KVR-CIBER/luchtmeter-s3/fab/render_bottom.png

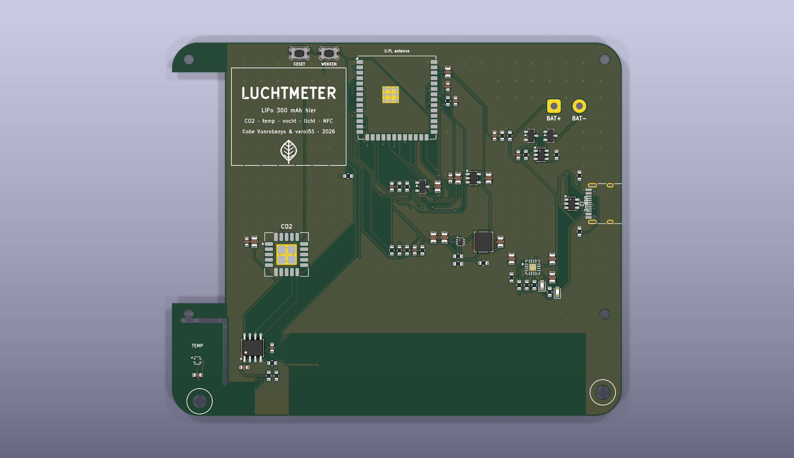
fab/render_bottom.png
