KVR-CIBER/luchtmeter-s3/fab/render_top.png

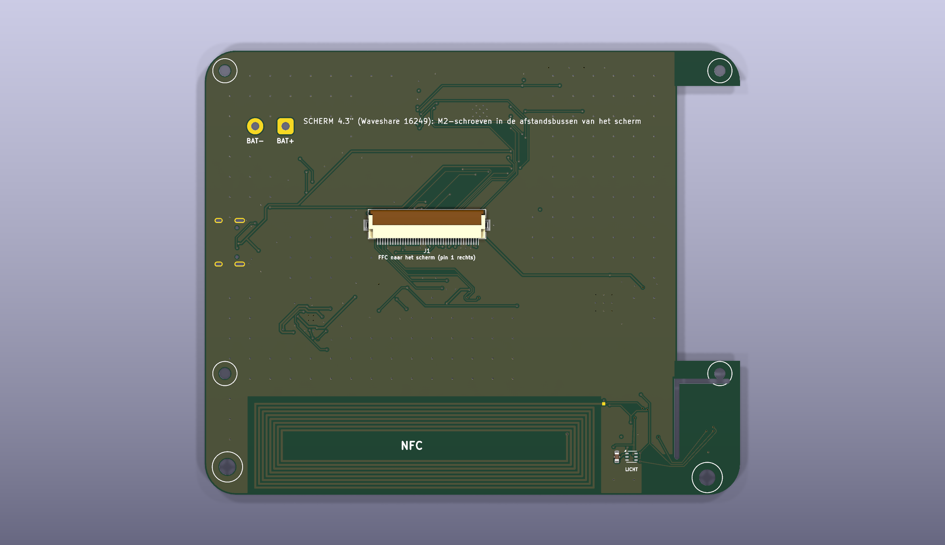
fab/render_top.png
