KVR-CIBER/luchtmeter-s3/fab/render_3d.png

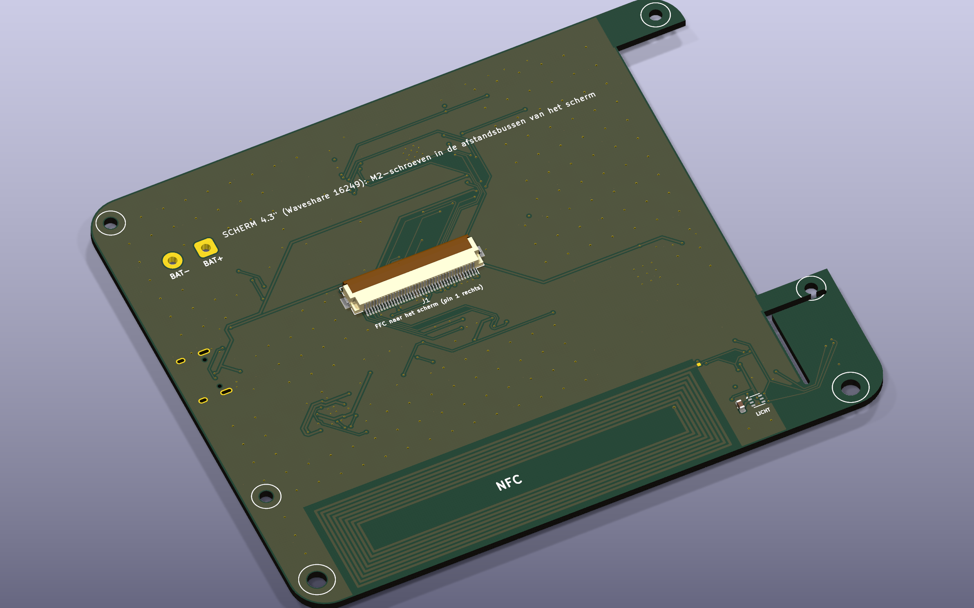
fab/render_3d.png
