KVR-CIBER/luchtmeter-s3/video/stills/luchtmeter_3s.jpg

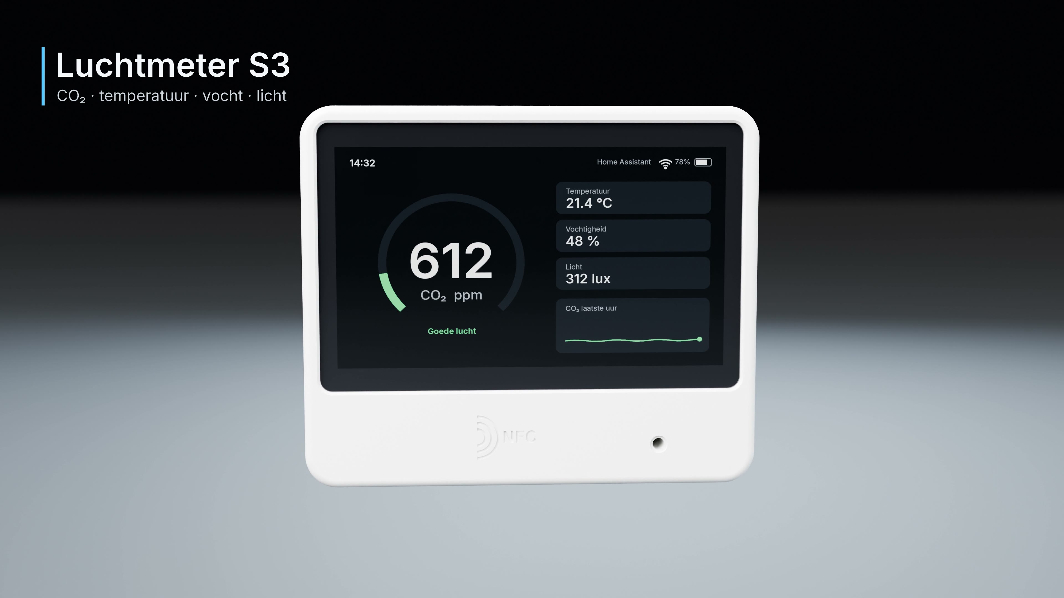
video/stills/luchtmeter_3s.jpg
