KVR-CIBER/luchtmeter-s3/video/stills/luchtmeter_13s.jpg

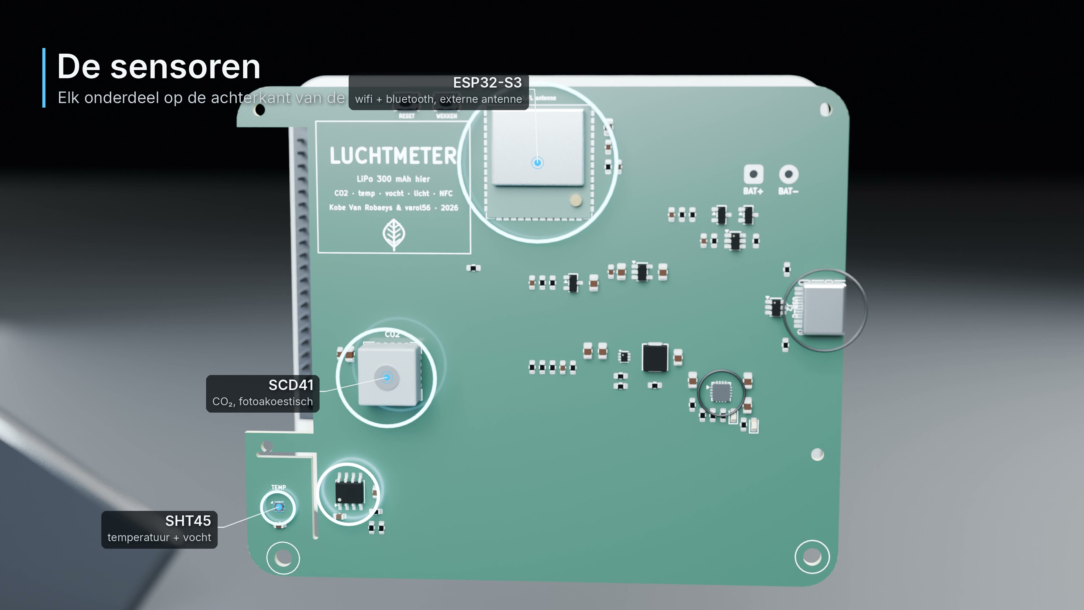
video/stills/luchtmeter_13s.jpg
