KVR-CIBER/luchtmeter-s3/video/stills/luchtmeter_23s.jpg

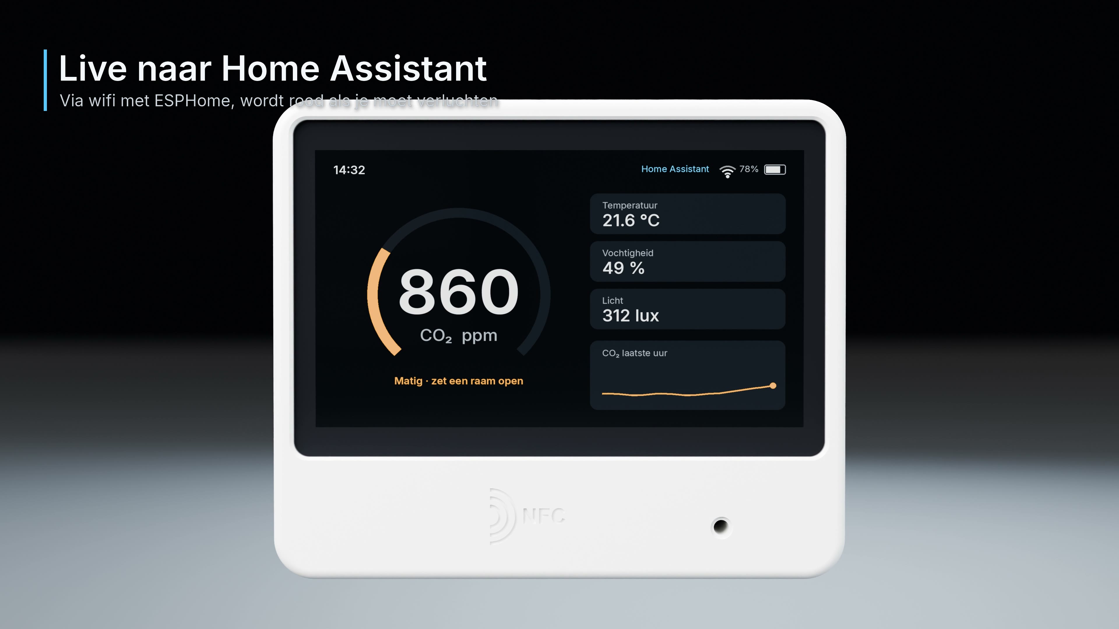
video/stills/luchtmeter_23s.jpg
