KVR-CIBER/luchtmeter-s3/video/stills/luchtmeter_31s.jpg

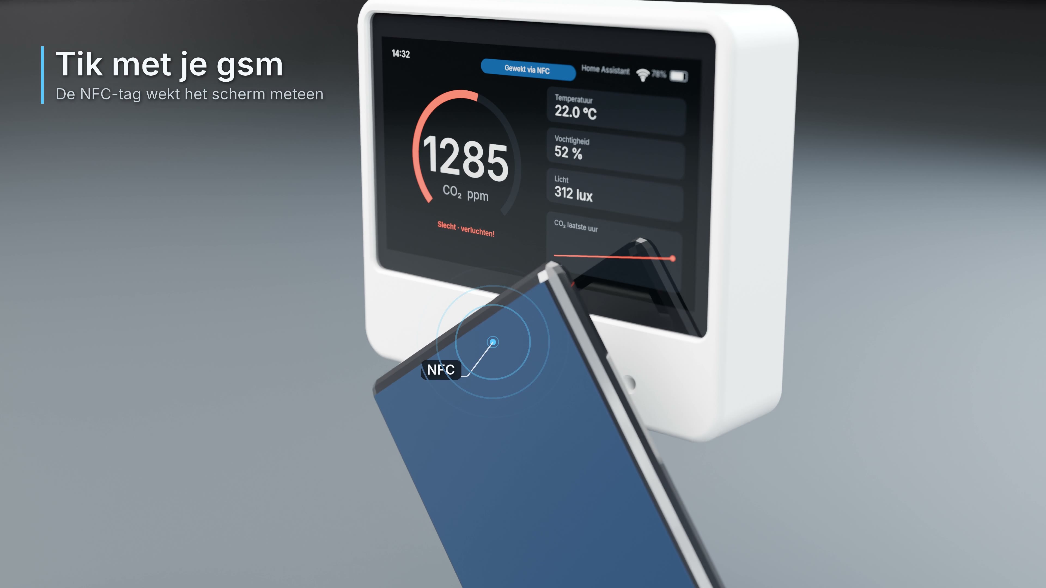
video/stills/luchtmeter_31s.jpg
