KVR-CIBER/luchtmeter-s3/fab/luchtmeter_BOM_JLCPCB.csv

Comment | Designator | Footprint | Quantity | MPN / note | LCSC Part #
ESP32-S3-WROOM-1U-N16R8 | U1 | ESP32-S3-WROOM-1U | 1 | ESP32-S3-WROOM-1U-N16R8 (U.FL; use a 2.4 GHz flex/dipole antenna at the top of the case) | C3013946
22u | C1,C10,C15,C16 | C_0805_2012Metric | 4 | 0805 22u X5R ceramic | C29277
100n | C2,C7,C8,C11,C18,C20,C21,C22 | C_0603_1608Metric | 8 | 0603 100n X7R ceramic | C14663
10k | R1,R2,R15 | R_0603_1608Metric | 3 | 0603 10k 1% | C25804
1u | C3,C17 | C_0603_1608Metric | 2 | 0603 1u X5R ceramic | C15849
WEKKEN | SW1 | SW_Push_1P1T_NO_CK_KMR2 | 1 | CK KMR221G: wake from deep sleep (= BOOT when held at reset) | C72443
RESET | SW2 | SW_Push_1P1T_NO_CK_KMR2 | 1 | CK KMR221G | C72443
USB-C | J2 | USB_C_Receptacle_HRO_TYPE-C-31-M-12 | 1 | HRO TYPE-C-31-M-12 | C165948
5k1 | R3,R4 | R_0603_1608Metric | 2 | 0603 5k1 1% | C23186
USBLC6-2SC6 | U2 | SOT-23-6 | 1 | USBLC6-2SC6 | C2687116
BQ24075 | U7 | VQFN-16-1EP_3x3mm_P0.5mm_EP1.6x1.6mm | 1 | TI BQ24075RGTR (Li-ion charger + power path) | C15464
4u7 | C4,C6 | C_0805_2012Metric | 2 | 0805 4u7 X5R ceramic | C132173
10u | C5,C9,C13,C14,C19 | C_0805_2012Metric | 5 | 0805 10u X5R ceramic | C15850
3.6k | R5 | R_0603_1608Metric | 1 | 0603 3.6k 1% (charge ~250 mA; 1k = 0.9 A) | C22980
1.1k | R6 | R_0603_1608Metric | 1 | 0603 1.1k 1% (input limit ~1.4 A) | C22764
10k | R7 | R_0603_1608Metric | 1 | 0603 10k 1% (TS: fixed 10k, no NTC) | C25804
1k | R8,R9,R11 | R_0603_1608Metric | 3 | 0603 1k 1% | C21190
rood laden | D1 | LED_0603_1608Metric | 1 | LED 0603 red (charging) | C2286
groen USB | D2 | LED_0603_1608Metric | 1 | LED 0603 green (USB power) | C12624
BATTERIJ | J4 | SolderWire_2pad_P6mm_D1.6mm_BAT | 1 | solder pads for the LiPo leads | (solder pads, no part)
DW01A | U8 | SOT-23-6 | 1 | DW01A (Li-ion protection) | C351410
100 | R10 | R_0603_1608Metric | 1 | 0603 100 1% | C22775
AO3400A | Q3 | SOT-23 | 1 | AO3400A (discharge FET) | C20917
AO3400A | Q4 | SOT-23 | 1 | AO3400A (charge FET) | C20917
1M | R12 | R_0603_1608Metric | 1 | 0603 1M 1% (battery voltage / 2) | C22935
1M | R13 | R_0603_1608Metric | 1 | 0603 1M 1% | C22935
XC6220B331MR | U3 | SOT-23-5 | 1 | Torex XC6220B331MR-G | C86534
AO3401A | Q2 | SOT-23 | 1 | AO3401A (load switch: sensors + NFC) | C15127
100k | R14,R17,R25 | R_0603_1608Metric | 3 | 0603 100k 1% | C25803
47n | C12 | C_0603_1608Metric | 1 | 0603 47n X7R ceramic | C107093
TPS61023 | U9 | SOT-563 | 1 | TI TPS61023DRLR (3.7 A boost, 0.1 uA shutdown) | C919459
1uH | L1 | L_Sunlord_MWSA0402S | 1 | Sunlord MWSA0402S-1R0MT (1 uH) | C408332
732k | R16 | R_0603_1608Metric | 1 | 0603 732k 1% | C23239
100k | R18 | R_0603_1608Metric | 1 | 0603 100k (screen off at boot / in sleep) | C25803
SCHERM | J1 | Hirose_FH12-40S-0.5SH_1x40-1MP_P0.50mm_Horizontal | 1 | Hirose FH12-40S-0.5SH(55): 40-pin 0.5 mm FFC to the Waveshare 4.3in Capacitive Touch LCD (RGB cable interface) | C202114
10k | R19 | R_0603_1608Metric | 1 | 0603 10k (GT911 power-on reset) | C25804
10k | R20 | R_0603_1608Metric | 1 | 0603 10k (INT low at reset -> GT911 address 0x5D) | C25804
4k7 | R21,R22,R23,R24 | R_0603_1608Metric | 4 | 0603 4k7 1% | C23162
LTR-303ALS-01 | U4 | Lite-On_LTR-303ALS-01 | 1 | LTR-303ALS-01 (ambient light, front window) | C364577
SCD41-D-R2 | U5 | Sensirion_SCD4x-1EP_10.1x10.1mm_P1.25mm_EP4.8x4.8mm | 1 | Sensirion SCD41-D-R2 (CO2 400-5000 ppm + RH/T), behind the back vents | C3659294
SHT45 | U6 | Sensirion_DFN-4_1.5x1.5mm_P0.8mm_SHT4x_NoCentralPad | 1 | Sensirion SHT45-AD1B-R2 (+-0.1 C) | C5221601
ST25DV04K | U10 | SOIC-8_3.9x4.9mm_P1.27mm | 1 | ST ST25DV04K-IER6S3 (dynamic NFC tag, I2C) | C155601
NFC antenne | ANT1 | NFC_Coil | 1 | PCB loop antenna (copper on the board, no part) | (PCB copper, no part)
10p | C23 | C_0603_1608Metric | 1 | 0603 10p C0G (3.5 uH coil + 28.5 pF internal + 10 pF = 13.6 MHz; tune 8-15 pF) | C1634
