KVR-CIBER/luchtmeter-s3/docs/waveshare43/drawing/4.3inch Capacitive Touch LCD 3D Drawing/1.stp

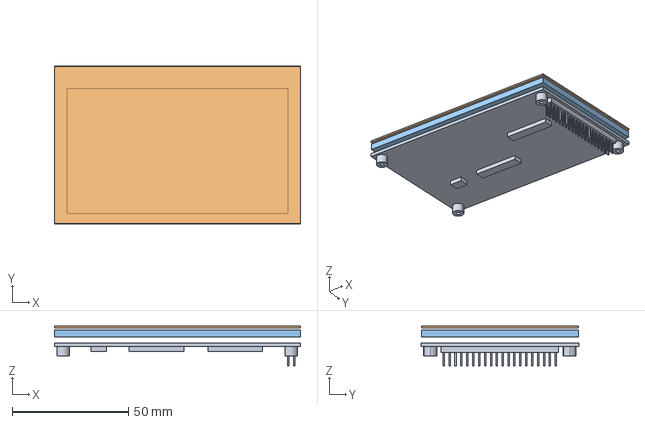
[picture p8: CAD file, 2026-10-19]
docs/waveshare43/drawing/4.3inch Capacitive Touch LCD 3D Drawing/1.stp
106.0 x 67.9 x 17.2 mm
