KVR-CIBER/luchtmeter-s3/luchtmeter.kicad_pcb

## KiCad design luchtmeter.kicad_pcb (2026-10-21)

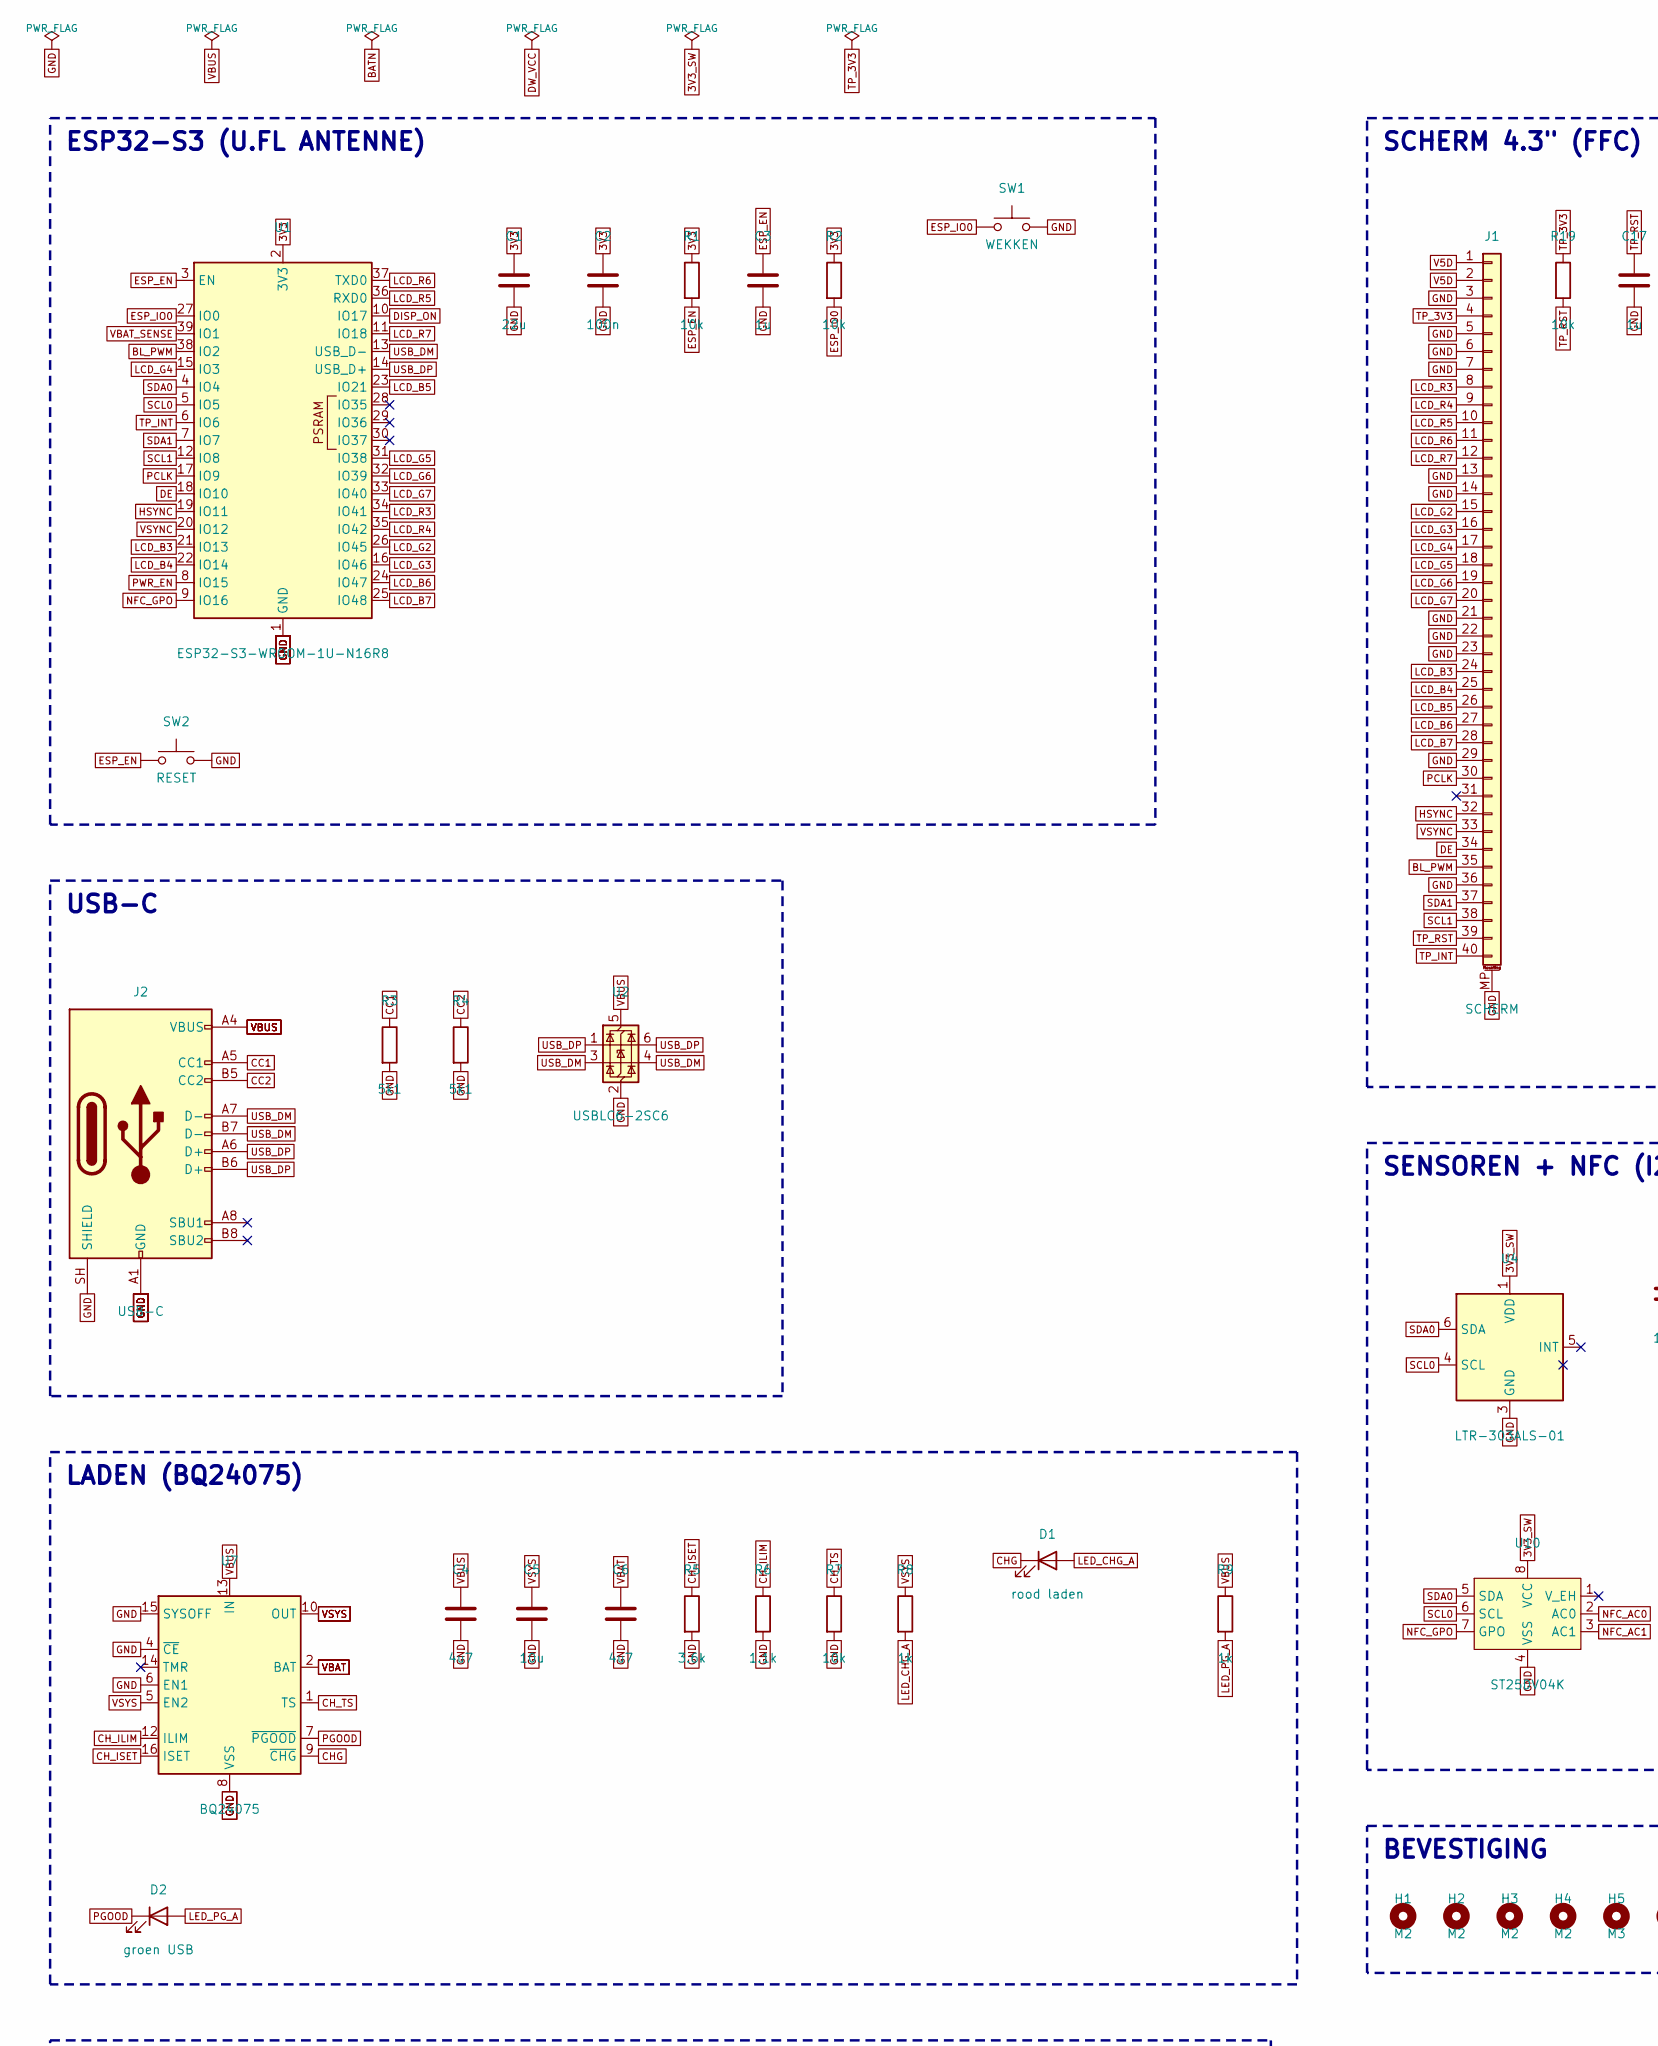
[picture p10: schematic luchtmeter.kicad_sch, Luchtmeter S3, part in row 1, column 1]

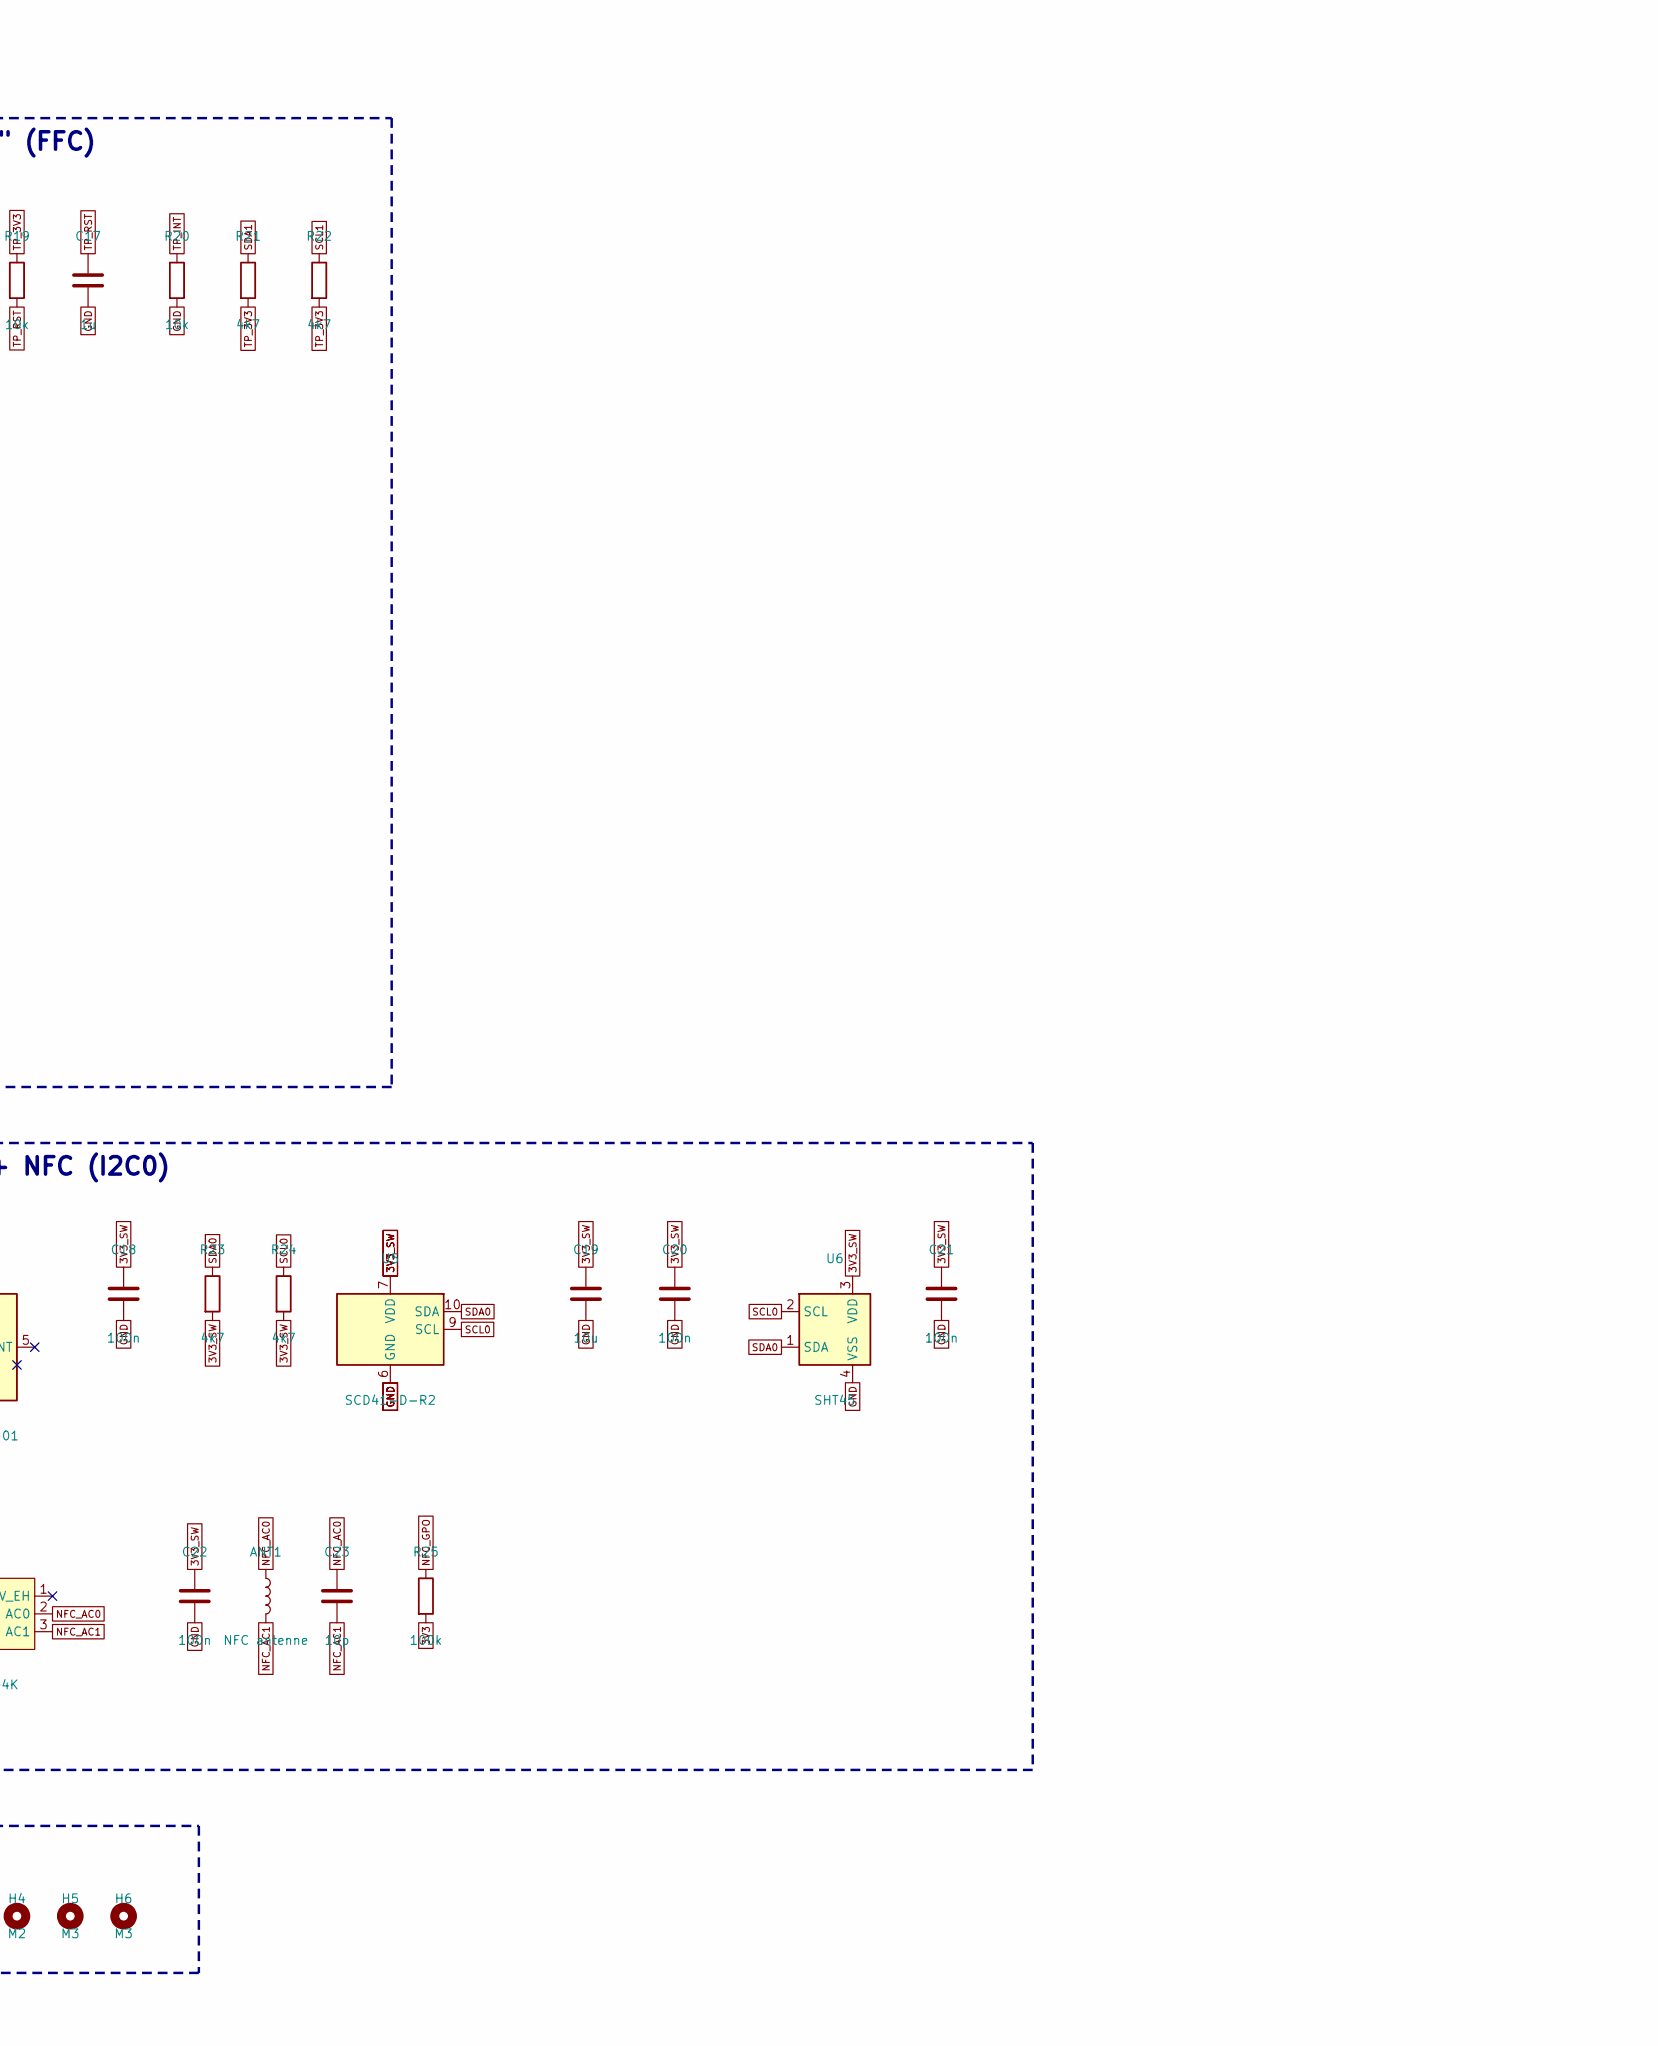
[picture p11: schematic luchtmeter.kicad_sch, Luchtmeter S3, part in row 1, column 2]

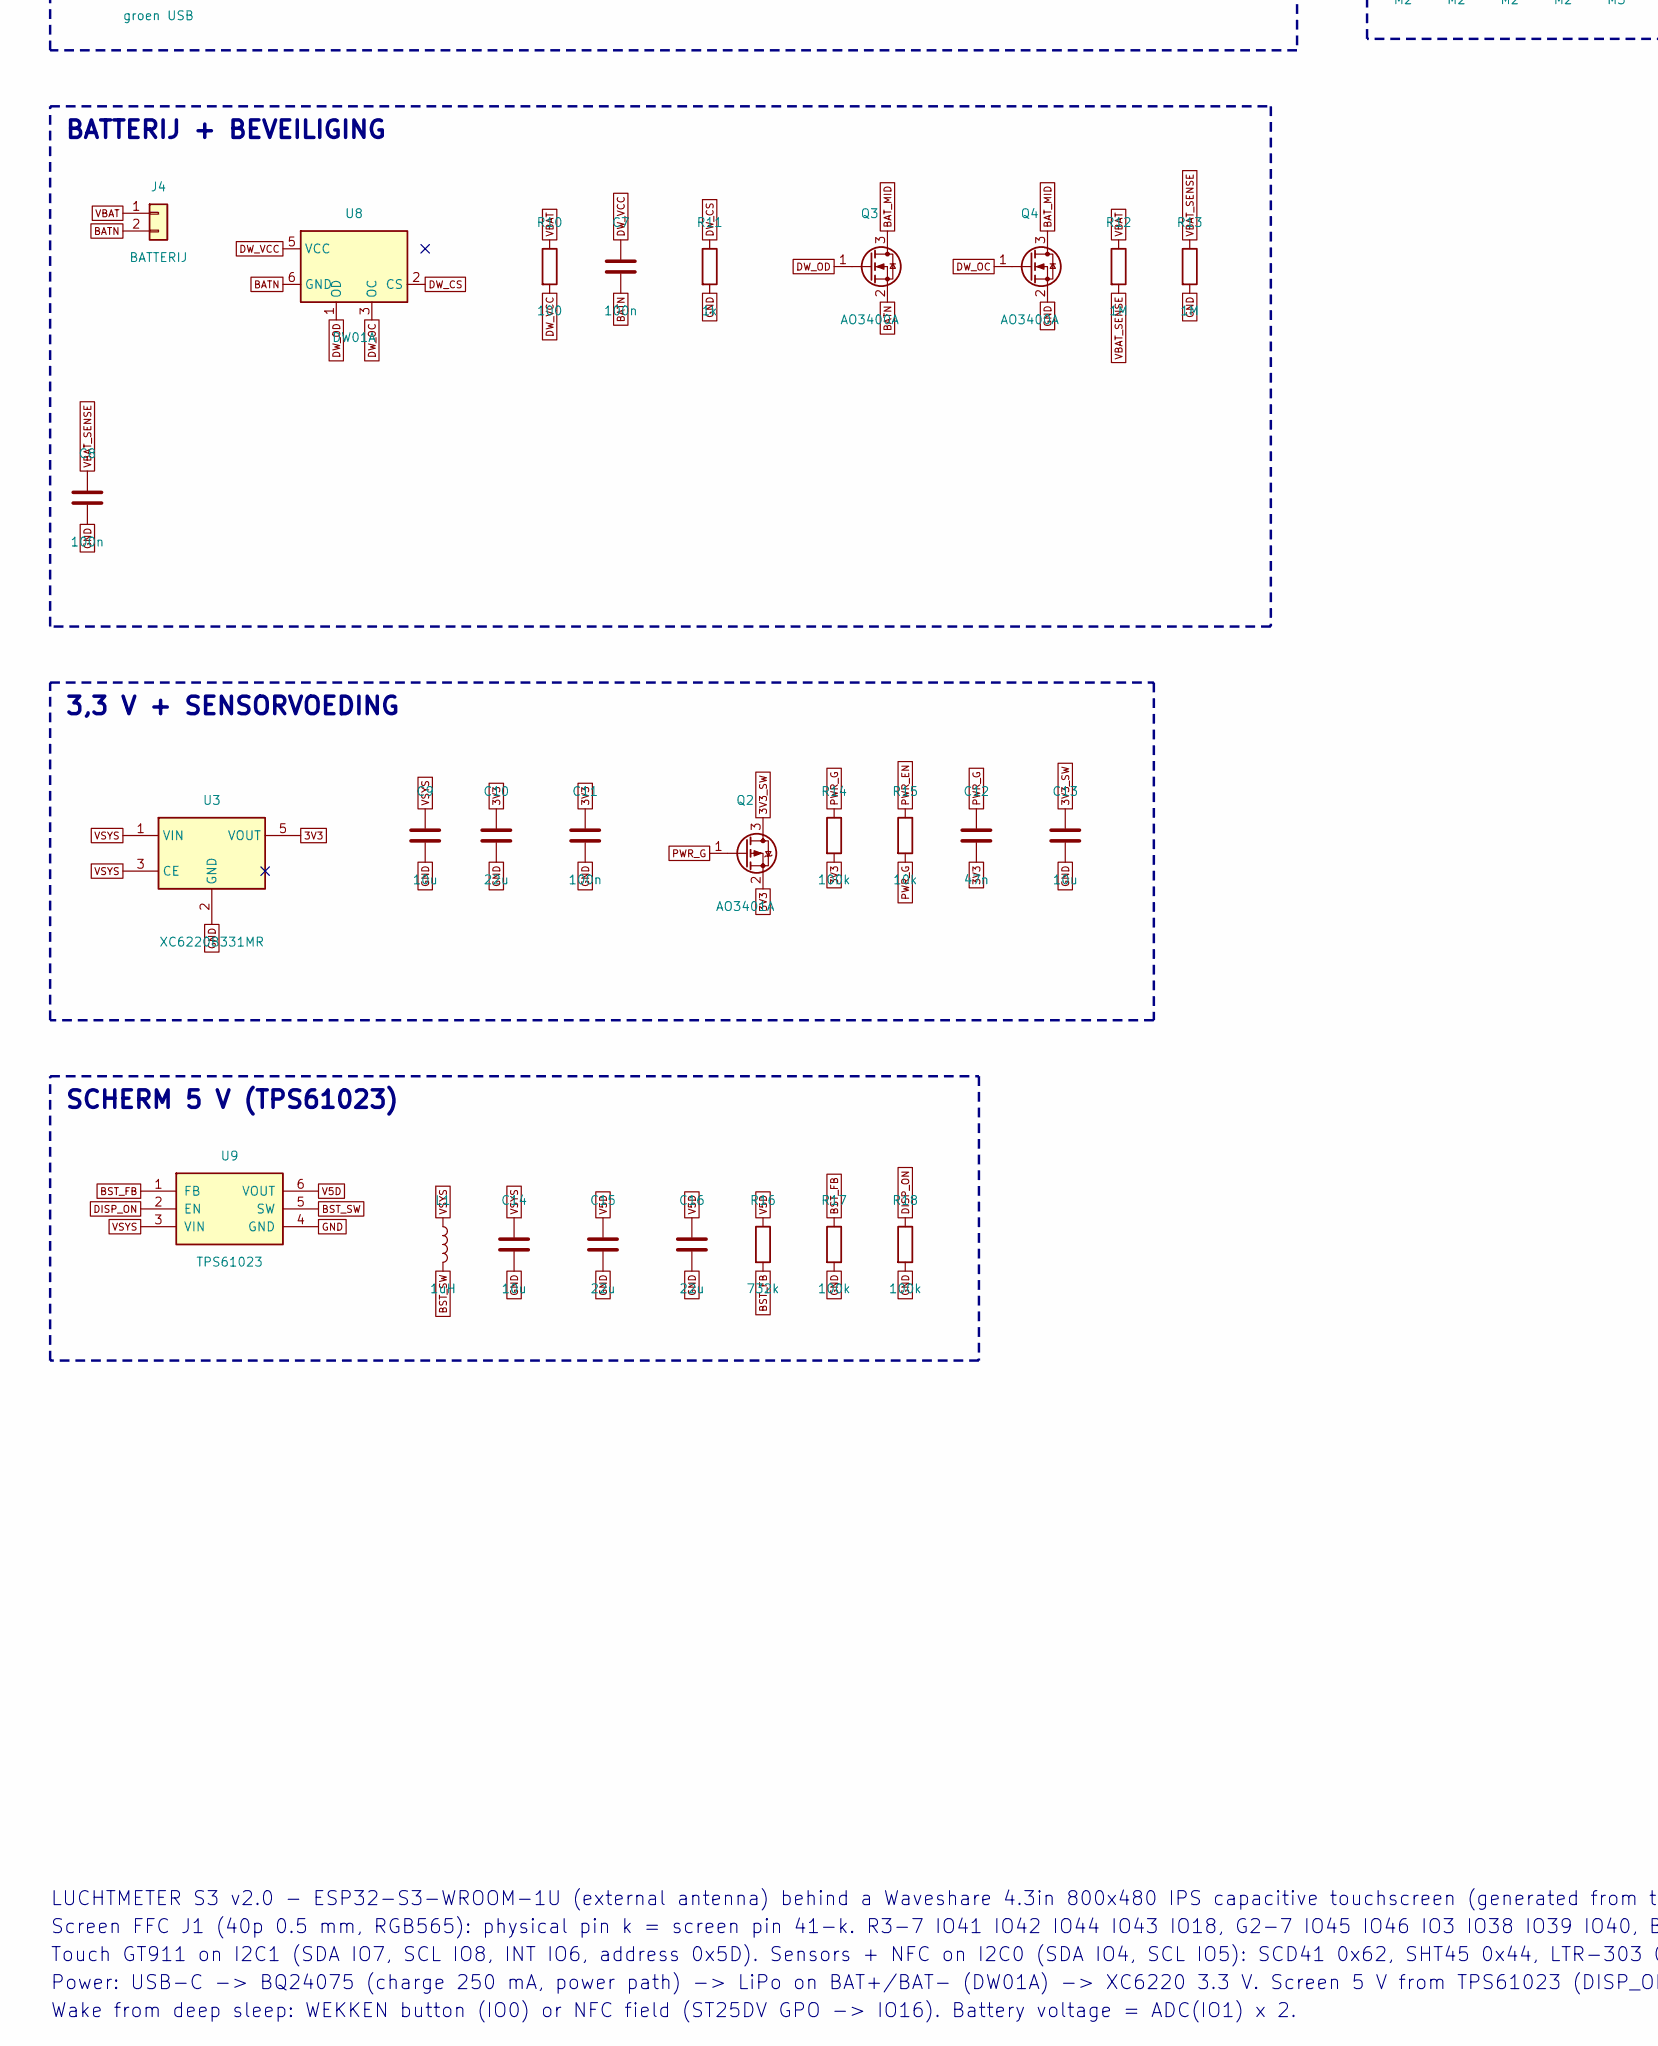
[picture p12: schematic luchtmeter.kicad_sch, Luchtmeter S3, part in row 2, column 1]

Parts:
ANT1: NFC antenne; NFC_Coil; MPN PCB loop antenna (copper on the board, 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
C1, C10, C15, C16: 22u; C_0805_2012Metric; MPN 0805 22u X5R ceramic
C2, C7, C8, C11, C18, C20, C21, C22: 100n; C_0603_1608Metric; MPN 0603 100n X7R ceramic
C3, C17: 1u; C_0603_1608Metric; MPN 0603 1u X5R ceramic
C4, C6: 4u7; C_0805_2012Metric; MPN 0805 4u7 X5R ceramic
C5, C9, C13, C14, C19: 10u; C_0805_2012Metric; MPN 0805 10u X5R ceramic
C12: 47n; C_0603_1608Metric; MPN 0603 47n X7R ceramic
C23: 10p; C_0603_1608Metric; MPN 0603 10p C0G (3.5 uH coil + 28.5 pF int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
D1: rood laden; LED_0603_1608Metric; MPN LED 0603 red (charging)
D2: groen USB; LED_0603_1608Metric; MPN LED 0603 green (USB power)
H1, H2, H3, H4: M2; MountingHole_2.2mm_M2
H5, H6: M3; MountingHole_3.2mm_M3
J1: SCHERM; Hirose_FH12-40S-0.5SH_1x40-1MP_P0.50mm_Horizontal; MPN Hirose FH12-40S-0.5SH(55): 40-pin 0.5 m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
J2: USB-C; USB_C_Receptacle_HRO_TYPE-C-31-M-12; MPN HRO TYPE-C-31-M-12
J4: BATTERIJ; SolderWire_2pad_P6mm_D1.6mm_BAT; MPN solder pads for the LiPo leads
L1: 1uH; L_Sunlord_MWSA0402S; MPN Sunlord MWSA0402S-1R0MT (1 uH)
Q2: AO3401A; SOT-23; MPN AO3401A (load switch: sensors + NFC)
Q3: AO3400A; SOT-23; MPN AO3400A (discharge FET)
Q4: AO3400A; SOT-23; MPN AO3400A (charge FET)
R1, R2, R15: 10k; R_0603_1608Metric; MPN 0603 10k 1%
R3, R4: 5k1; R_0603_1608Metric; MPN 0603 5k1 1%
R5: 3.6k; R_0603_1608Metric; MPN 0603 3.6k 1% (charge ~250 mA; 1k = 0.9 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
R6: 1.1k; R_0603_1608Metric; MPN 0603 1.1k 1% (input limit ~1.4 A)
R7: 10k; R_0603_1608Metric; MPN 0603 10k 1% (TS: fixed 10k, no NTC)
R8, R9, R11: 1k; R_0603_1608Metric; MPN 0603 1k 1%
R10: 100; R_0603_1608Metric; MPN 0603 100 1%
R12: 1M; R_0603_1608Metric; MPN 0603 1M 1% (battery voltage / 2)
R13: 1M; R_0603_1608Metric; MPN 0603 1M 1%
R14, R17, R25: 100k; R_0603_1608Metric; MPN 0603 100k 1%
R16: 732k; R_0603_1608Metric; MPN 0603 732k 1%
R18: 100k; R_0603_1608Metric; MPN 0603 100k (screen off at boot / in slee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
R19: 10k; R_0603_1608Metric; MPN 0603 10k (GT911 power-on reset)
R20: 10k; R_0603_1608Metric; MPN 0603 10k (INT low at reset -> GT911 add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
R21, R22, R23, R24: 4k7; R_0603_1608Metric; MPN 0603 4k7 1%
SW1: WEKKEN; SW_Push_1P1T_NO_CK_KMR2; MPN CK KMR221G: wake from deep sleep (= BOO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
SW2: RESET; SW_Push_1P1T_NO_CK_KMR2; MPN CK KMR221G
U1: ESP32-S3-WROOM-1U-N16R8; ESP32-S3-WROOM-1U; MPN ESP32-S3-WROOM-1U-N16R8 (U.FL; use a 2.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
U2: USBLC6-2SC6; SOT-23-6; MPN USBLC6-2SC6
U3: XC6220B331MR; SOT-23-5; MPN Torex XC6220B331MR-G
U4: LTR-303ALS-01; Lite-On_LTR-303ALS-01; MPN LTR-303ALS-01 (ambient light, front win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
U5: SCD41-D-R2; Sensirion_SCD4x-1EP_10.1x10.1mm_P1.25mm_EP4.8x4.8mm; MPN Sensirion SCD41-D-R2 (CO2 400-5000 ppm 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
U6: SHT45; Sensirion_DFN-4_1.5x1.5mm_P0.8mm_SHT4x_NoCentralPad; MPN Sensirion SHT45-AD1B-R2 (+-0.1 C)
U7: BQ24075; VQFN-16-1EP_3x3mm_P0.5mm_EP1.6x1.6mm; MPN TI BQ24075RGTR (Li-ion charger + power 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
U8: DW01A; SOT-23-6; MPN DW01A (Li-ion protection)
U9: TPS61023; SOT-563; MPN TI TPS61023DRLR (3.7 A boost, 0.1 uA sh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
U10: ST25DV04K; SOIC-8_3.9x4.9mm_P1.27mm; MPN ST ST25DV04K-IER6S3 (dynamic NFC tag, I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

Connections:
3V3: C1.1, C2.1, C10.1, C11.1, C12.2, Q2.2 (S), R1.1, R2.1, R14.2, R25.2, U1.2 (3V3), U3.5 (VOUT)
3V3_SW: C13.1, C18.1, C19.1, C20.1, C21.1, C22.1, Q2.3 (D), R23.2, R24.2, U4.1 (VDD), U5.7 (VDD), U5.19 (VDD), U6.3 (VDD), U10.8 (VCC)
BATN: C7.2, J4.2, Q3.2 (S), U8.6 (GND)
BAT_MID: Q3.3 (D), Q4.3 (D)
BL_PWM: J1.35, U1.38 (IO2)
BST_FB: R16.2, R17.1, U9.1 (FB)
BST_SW: L1.2, U9.5 (SW)
CC1: J2.A5 (CC1), R3.1
CC2: J2.B5 (CC2), R4.1
CHG: D1.1 (K), U7.9 (~CHG)
CH_ILIM: R6.1, U7.12 (ILIM)
CH_ISET: R5.1, U7.16 (ISET)
CH_TS: R7.1, U7.1 (TS)
DE: J1.34, U1.18 (IO10)
DISP_ON: R18.1, U1.10 (IO17), U9.2 (EN)
DW_CS: R11.1, U8.2 (CS)
DW_OC: Q4.1 (G), U8.3 (OC)
DW_OD: Q3.1 (G), U8.1 (OD)
DW_VCC: C7.1, R10.2, U8.5 (VCC)
ESP_EN: C3.1, R1.2, SW2.1, U1.3 (EN)
ESP_IO0: R2.2, SW1.1, U1.27 (IO0)
GND: C1.2, C2.2, C3.2, C4.2, C5.2, C6.2, C8.2, C9.2, C10.2, C11.2, C13.2, C14.2, C15.2, C16.2, C17.2, C18.2, C19.2, C20.2, C21.2, C22.2, J1.3, J1.5, J1.6, J1.7, J1.13, J1.14, J1.21, J1.22, J1.23, J1.29, J1.36, J1.MP (MountPin), J2.A1 (GND), J2.A12 (GND), J2.B1 (GND), J2.B12 (GND), J2.SH (SHIELD), Q4.2 (S), R3.2, R4.2, R5.2, R6.2, R7.2, R11.2, R13.2, R17.2, R18.2, R20.2, SW1.2, SW2.2, U1.1 (GND), U1.40 (GND), U1.41 (GND), U2.2 (GND), U3.2 (GND), U4.3 (GND), U5.6 (GND), U5.20 (GND), U5.21 (GND), U6.4 (VSS), U7.4 (~CE), U7.6 (EN1), U7.8 (VSS), U7.15 (SYSOFF), U7.17 (VSS), U9.4 (GND), U10.4 (VSS)
HSYNC: J1.32, U1.19 (IO11)
LCD_B3: J1.24, U1.21 (IO13)
LCD_B4: J1.25, U1.22 (IO14)
LCD_B5: J1.26, U1.23 (IO21)
LCD_B6: J1.27, U1.24 (IO47)
LCD_B7: J1.28, U1.25 (IO48)
LCD_G2: J1.15, U1.26 (IO45)
LCD_G3: J1.16, U1.16 (IO46)
LCD_G4: J1.17, U1.15 (IO3)
LCD_G5: J1.18, U1.31 (IO38)
LCD_G6: J1.19, U1.32 (IO39)
LCD_G7: J1.20, U1.33 (IO40)
LCD_R3: J1.8, U1.34 (IO41)
LCD_R4: J1.9, U1.35 (IO42)
LCD_R5: J1.10, U1.36 (RXD0)
LCD_R6: J1.11, U1.37 (TXD0)
LCD_R7: J1.12, U1.11 (IO18)
LED_CHG_A: D1.2 (A), R8.2
LED_PG_A: D2.2 (A), R9.2
NFC_AC0: ANT1.1, C23.1, U10.2 (AC0)
NFC_AC1: ANT1.2, C23.2, U10.3 (AC1)
NFC_GPO: R25.1, U1.9 (IO16), U10.7 (GPO)
PCLK: J1.30, U1.17 (IO9)
PGOOD: D2.1 (K), U7.7 (~PGOOD)
PWR_EN: R15.1, U1.8 (IO15)
PWR_G: C12.1, Q2.1 (G), R14.1, R15.2
SCL0: R24.1, U1.5 (IO5), U4.4 (SCL), U5.9 (SCL), U6.2 (SCL), U10.6 (SCL)
SCL1: J1.38, R22.1, U1.12 (IO8)
SDA0: R23.1, U1.4 (IO4), U4.6 (SDA), U5.10 (SDA), U6.1 (SDA), U10.5 (SDA)
SDA1: J1.37, R21.1, U1.7 (IO7)
TP_3V3: J1.4, R19.1, R21.2, R22.2
TP_INT: J1.40, R20.1, U1.6 (IO6)
TP_RST: C17.1, J1.39, R19.2
USB_DM: J2.A7 (D-), J2.B7 (D-), U1.13 (USB_D-), U2.3 (I/O2), U2.4 (I/O2)
USB_DP: J2.A6 (D+), J2.B6 (D+), U1.14 (USB_D+), U2.1 (I/O1), U2.6 (I/O1)
V5D: C15.1, C16.1, J1.1, J1.2, R16.1, U9.6 (VOUT)
VBAT: C6.1, J4.1, R10.1, R12.1, U7.2 (BAT), U7.3 (BAT)
VBAT_SENSE: C8.1, R12.2, R13.1, U1.39 (IO1)
VBUS: C4.1, J2.A4 (VBUS), J2.A9 (VBUS), J2.B4 (VBUS), J2.B9 (VBUS), R9.1, U2.5 (VBUS), U7.13 (IN)
VSYNC: J1.33, U1.20 (IO12)
VSYS: C5.1, C9.1, C14.1, L1.1, R8.1, U3.1 (VIN), U3.3 (CE), U7.5 (EN2), U7.10 (OUT), U7.11 (OUT), U9.3 (VIN)

Notes on the sheet:
ESP32-S3 (U.FL ANTENNE)
USB-C
LADEN (BQ24075)
BATTERIJ + BEVEILIGING
3,3 V + SENSORVOEDING
SCHERM 5 V (TPS61023)
SCHERM 4.3" (FFC)
SENSOREN + NFC (I2C0)
BEVESTIGING
LUCHTMETER S3 v2.0 - ESP32-S3-WROOM-1U (external antenna) behind a Waveshare 4.3in 800x480 IPS capacitive touchscreen (generated from tools/design.py)
Screen FFC J1 (40p 0.5 mm, RGB565): physical pin k = screen pin 41-k. R3-7 IO41 IO42 IO44 IO43 IO18, G2-7 IO45 IO46 IO3 IO38 IO39 IO40, B3-7 IO13 IO14 IO21 IO47 IO48, PCLK IO9 DE IO10 HSYNC IO11 VSYNC IO12, backlight PWM IO2.
Touch GT911 on I2C1 (SDA IO7, SCL IO8, INT IO6, address 0x5D). Sensors + NFC on I2C0 (SDA IO4, SCL IO5): SCD41 0x62, SHT45 0x44, LTR-303 0x29, ST25DV 0x53/0x57/0x2D.
Power: USB-C -> BQ24075 (charge 250 mA, power path) -> LiPo on BAT+/BAT- (DW01A) -> XC6220 3.3 V. Screen 5 V from TPS61023 (DISP_ON IO17 high). Sensors + NFC on 3V3_SW (PWR_EN IO15 low = on).
Wake from deep sleep: WEKKEN button (IO0) or NFC field (ST25DV GPO -> IO16). Battery voltage = ADC(IO1) x 2.

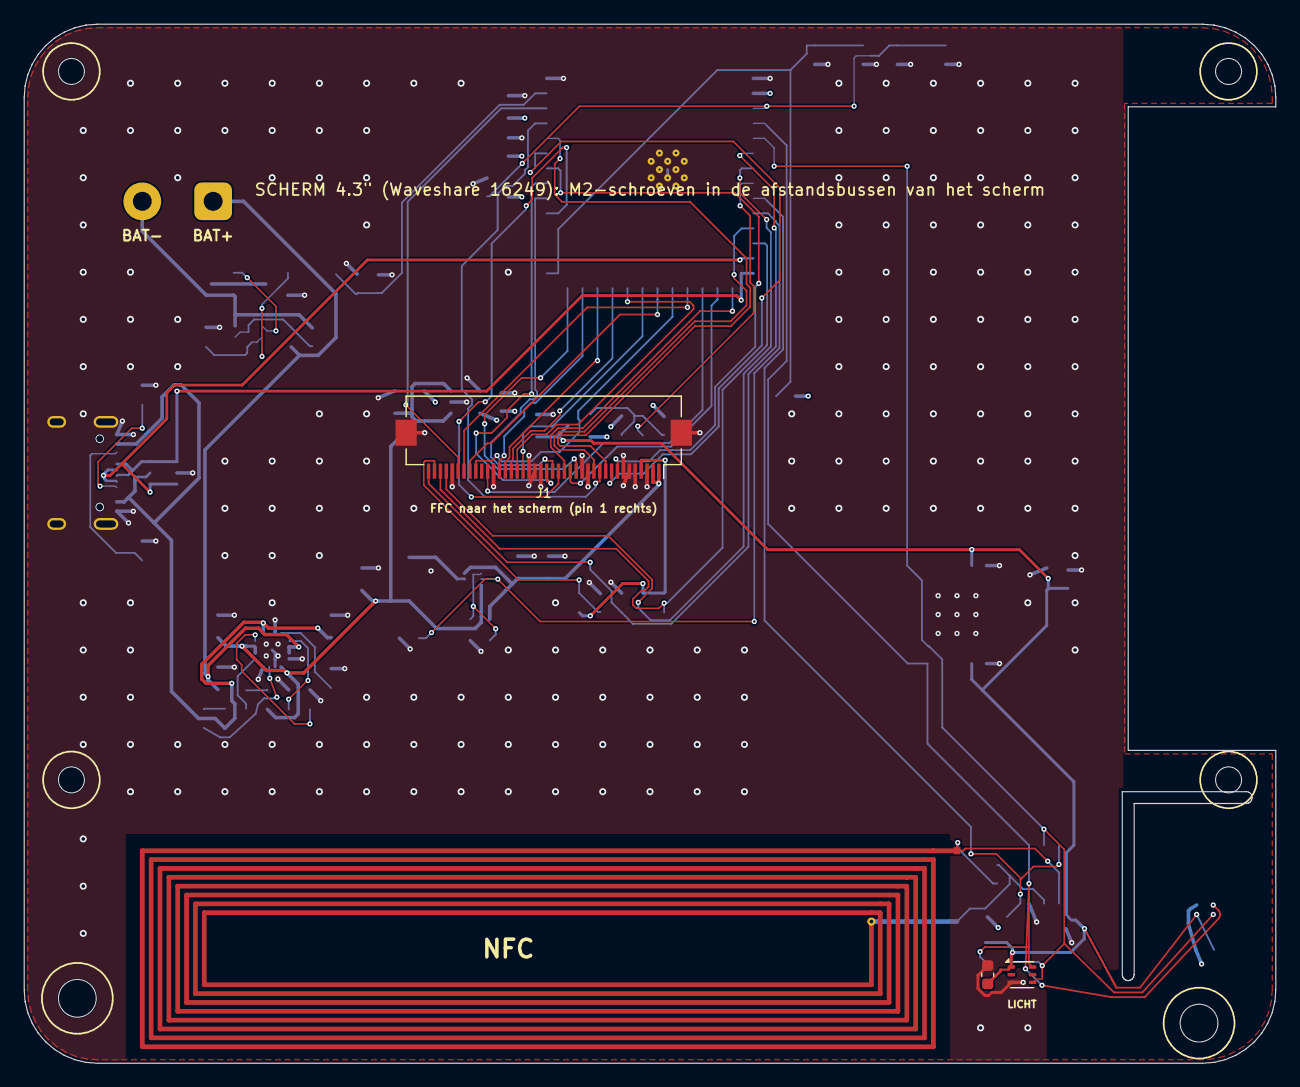
[picture p13: board luchtmeter.kicad_pcb from above]

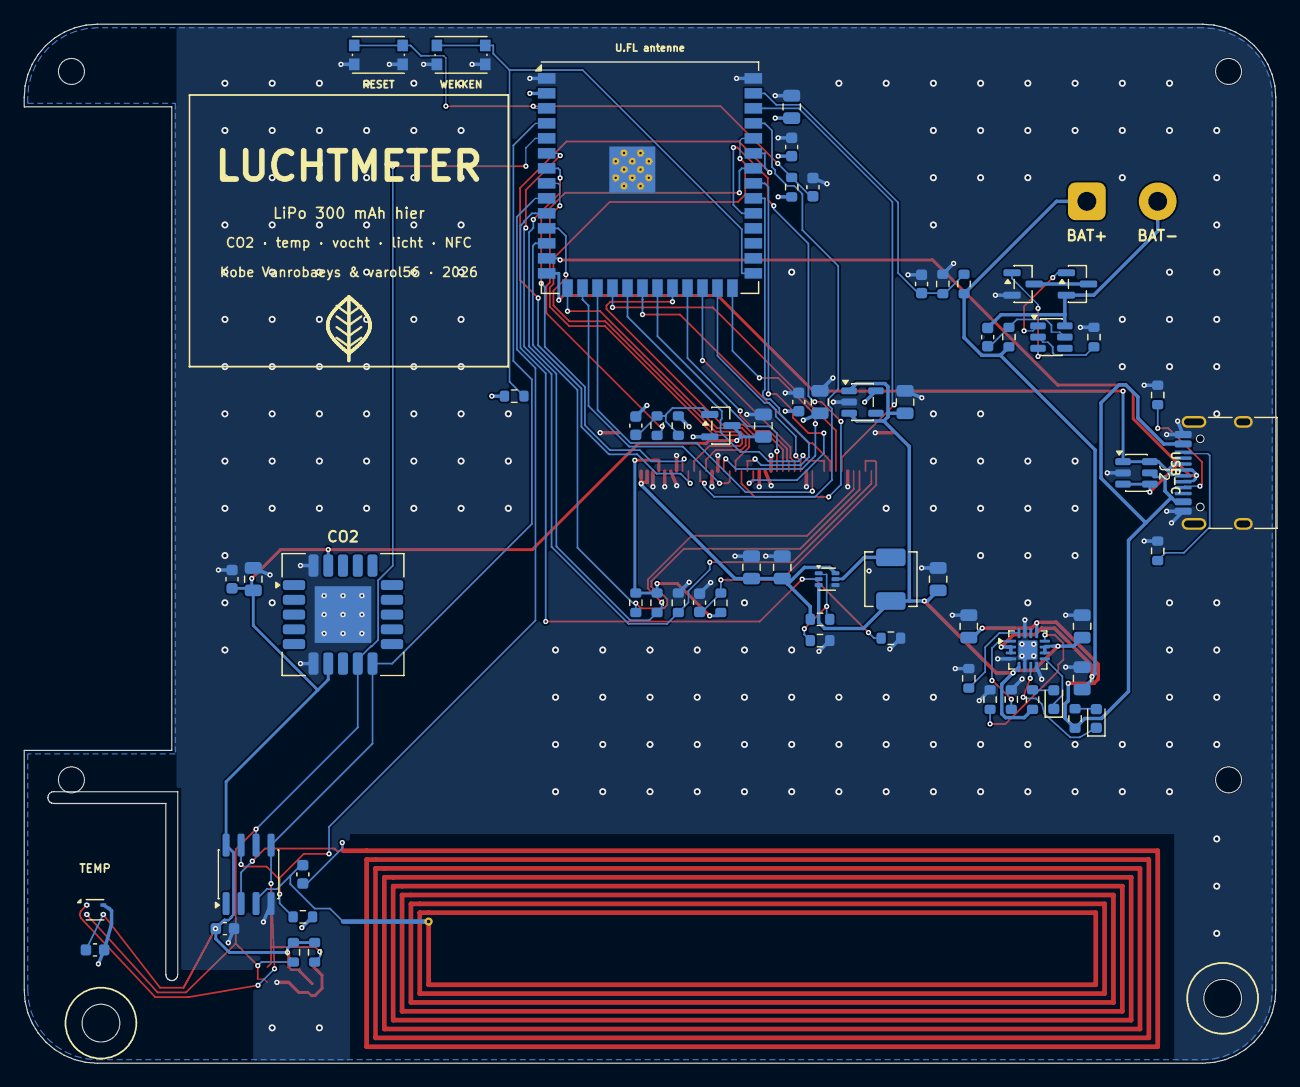
[picture p14: board luchtmeter.kicad_pcb from below]

Board: 4 copper layers, 106.0 x 88.0 mm, 76 parts (66 on the bottom side), 63 nets.
