KVR-CIBER/luchtmeter-s3/tools/libs.py

import sys
"""Build the self-contained project libraries: lucht.kicad_sym and lucht.pretty."""
import os, re, json, shutil, copy
import symlib
from sexp import parse, dump, find, find1, Sym
import design

HERE = os.path.dirname(os.path.abspath(__file__))
PRJ = os.path.dirname(HERE)
FPDIR = '/Applications/KiCad/KiCad.app/Contents/SharedSupport/footprints/'
LIB = 'lucht'


def fp_name(fpid):
    return fpid.split(':')[1]


def sym_name(symid):
    lib, name = symid.split(':')
    return name


# ---------------------------------------------------------------- custom footprints
def fp_text(name, body, descr, attr='through_hole'):
    return f'''(footprint "{name}"
\t(version 20241229)
\t(generator "lucht_gen")
\t(layer "F.Cu")
\t(descr "{descr}")
\t(property "Reference" "REF**" (at 0 -4 0) (layer "F.SilkS") (effects (font (size 1 1) (thickness 0.15))))
\t(property "Value" "{name}" (at 0 4 0) (layer "F.Fab") (effects (font (size 1 1) (thickness 0.15))))
\t(attr {attr})
{body})
'''


def mount_hole_m3():
    b = '\t(pad "" np_thru_hole circle (at 0 0) (size 3.2 3.2) (drill 3.2) (layers "*.Cu" "*.Mask"))\n'
    b += '\t(fp_circle (center 0 0) (end 3.0 0) (stroke (width 0.15) (type solid)) (fill no) (layer "F.SilkS"))\n'
    b += '\t(fp_circle (center 0 0) (end 3.0 0) (stroke (width 0.15) (type solid)) (fill no) (layer "B.SilkS"))\n'
    b += '\t(fp_circle (center 0 0) (end 3.3 0) (stroke (width 0.05) (type solid)) (fill no) (layer "F.CrtYd"))\n'
    return fp_text('MountingHole_3.2mm_M3', b, 'M3 hole (3.2 mm): display standoffs / case', attr='exclude_from_pos_files exclude_from_bom')


def solder_pads_bat():
    b = '\t(pad "1" thru_hole roundrect (roundrect_rratio 0.2) (at 0 0) (size 3.2 3.2) (drill 1.6) (layers "*.Cu" "*.Mask"))\n'
    b += '\t(pad "2" thru_hole circle (at 6 0) (size 3.2 3.2) (drill 1.6) (layers "*.Cu" "*.Mask"))\n'
    for lay in ('F.SilkS', 'B.SilkS'):
        mir = ' (justify mirror)' if lay == 'B.SilkS' else ''
        b += f'\t(fp_text user "BAT+" (at 0 2.9 0) (layer "{lay}") (effects (font (size 0.9 0.9) (thickness 0.18)){mir}))\n'
        b += f'\t(fp_text user "BAT-" (at 6 2.9 0) (layer "{lay}") (effects (font (size 0.9 0.9) (thickness 0.18)){mir}))\n'
    b += '\t(fp_rect (start -2.2 -2.2) (end 8.2 3.8) (stroke (width 0.05) (type solid)) (fill no) (layer "F.CrtYd"))\n'
    return fp_text('SolderWire_2pad_P6mm_D1.6mm_BAT', b, 'Two solder pads for the 18650 Li-ion cell leads (18 AWG)')


def mount_hole_m2():
    b = '\t(pad "" np_thru_hole circle (at 0 0) (size 2.2 2.2) (drill 2.2) (layers "*.Cu" "*.Mask"))\n'
    b += '\t(fp_circle (center 0 0) (end 2.4 0) (stroke (width 0.15) (type solid)) (fill no) (layer "F.SilkS"))\n'
    b += '\t(fp_circle (center 0 0) (end 2.7 0) (stroke (width 0.05) (type solid)) (fill no) (layer "F.CrtYd"))\n'
    return fp_text('MountingHole_2.2mm_M2', b, 'M2 hole for the screen standoffs', attr='exclude_from_pos_files exclude_from_bom')


def nfc_coil():
    """NFC loop antenna as a net-tie footprint (placed at board origin, coordinates = board coordinates):
    F.Cu spiral from pad 1 (outer end) inwards, via (pad 2) at the inner end, the B.Cu bridge out of the coil is a board track (build_pcb)."""
    c = design.NFC; p = c['w'] + c['s']
    x0, y0, x1, y1, n = c['x0'], c['y0'], c['x1'], c['y1'], c['turns']
    pts = [(x1 + 2.0, y0), (x1, y0)]
    for k in range(n):
        a, b_, cc, d = x0 + k * p, y0 + k * p, x1 - k * p, y1 - k * p
        pts += [(a, b_), (a, d), (cc, d), (cc, b_ + p)]
        if k < n - 1:
            pts.append((cc - p, b_ + p))
    w = c['w']; ex, ey = pts[-1]
    b = '\t(net_tie_pad_groups "1,2")\n'
    for (ax, ay), (bx, by) in zip(pts, pts[1:]):
        b += f'\t(fp_line (start {ax:.3f} {ay:.3f}) (end {bx:.3f} {by:.3f}) (stroke (width {w}) (type solid)) (layer "F.Cu"))\n'
    b += f'\t(pad "1" smd rect (at {x1 + 2.0:.3f} {y0:.3f}) (size 0.6 0.6) (layers "F.Cu" "F.Mask"))\n'
    b += f'\t(pad "2" thru_hole circle (at {ex:.3f} {ey:.3f}) (size 0.7 0.7) (drill 0.3) (layers "*.Cu"))\n'
    b += f'\t(fp_rect (start {x0 - 0.6:.2f} {y0 - 0.6:.2f}) (end {x1 + 2.6:.2f} {y1 + 0.6:.2f}) (stroke (width 0.05) (type solid)) (fill no) (layer "F.CrtYd"))\n'
    b += f'\t(fp_text user "NFC {n} windingen" (at {(x0 + x1) / 2:.2f} {y1 + 1.2:.2f} 0) (layer "F.Fab") (effects (font (size 0.8 0.8) (thickness 0.12))))\n'
    return fp_text('NFC_Coil', b, 'NFC loop antenna for the ST25DV (net tie: the coil is a DC short between AC0 and AC1)',
                   attr='smd exclude_from_pos_files')


def build_fp_lib():
    d = os.path.join(PRJ, LIB + '.pretty'); os.makedirs(d, exist_ok=True)
    for f in os.listdir(d):
        os.remove(os.path.join(d, f))
    custom = {'NFC_Coil': nfc_coil(), 'MountingHole_3.2mm_M3': mount_hole_m3(), 'MountingHole_2.2mm_M2': mount_hole_m2(), 'SolderWire_2pad_P6mm_D1.6mm_BAT': solder_pads_bat()}
    for n, t in custom.items():
        open(os.path.join(d, n + '.kicad_mod'), 'w').write(t)
    for p in design.parts:
        lib, n = p['fp'].split(':')
        if lib == LIB:
            continue
        shutil.copy(os.path.join(FPDIR, lib + '.pretty', n + '.kicad_mod'), os.path.join(d, n + '.kicad_mod'))
    # SHT45: drop the footprint's own track keep-out (it blocks the routers at the 0.8 mm pads); build_pcb keeps pours away
    sht = os.path.join(d, 'Sensirion_DFN-4_1.5x1.5mm_P0.8mm_SHT4x_NoCentralPad.kicad_mod')
    if os.path.exists(sht):
        t = open(sht).read()
        i = t.index('\t(zone'); depth = 0
        for j in range(i, len(t)):
            depth += (t[j] == '(') - (t[j] == ')')
            if depth == 0 and j > i:
                break
        open(sht, 'w').write(t[:i] + t[j + 2:])
    # ESP32-S3 module: KiCad's antenna keep-out is 48 x 21 mm beyond the module (made for an overhanging antenna).
    # Here the module is flush with the top edge: keep only the antenna width and the strip over the antenna itself.
    esp = os.path.join(d, 'ESP32-S3-WROOM-1.kicad_mod')
    if os.path.exists(esp):
        t = open(esp).read()
        assert '(xy -24 -6.75) (xy 24 -6.75) (xy 24 -27.75) (xy -24 -27.75)' in t
        t = t.replace('(xy -24 -6.75) (xy 24 -6.75) (xy 24 -27.75) (xy -24 -27.75)', '(xy -10.5 -6.75) (xy 10.5 -6.75) (xy 10.5 -16) (xy -10.5 -16)')
        for o, n in (('(start -24 -27.75)', '(start -10.5 -16)'), ('(end -24 -6.75)', '(end -10.5 -6.75)'), ('(start -24 -6.75)', '(start -10.5 -6.75)'),
                     ('(end 24 -6.75)', '(end 10.5 -6.75)'), ('(start 24 -27.75)', '(start 10.5 -16)'), ('(end -24 -27.75)', '(end -10.5 -16)'),
                     ('(start 24 -6.75)', '(start 10.5 -6.75)'), ('(end 24 -27.75)', '(end 10.5 -16)')):
            t = t.replace(o, n)
        open(esp, 'w').write(t)
    return d


# ---------------------------------------------------------------- symbols
def rename_sym(s, new):
    old = s[1]; s[1] = new
    for sub in find(s, 'symbol'):
        sub[1] = new + sub[1][len(old):]
    return s


def prop(name, val, at=(0, 0), hide=False, size=1.27):
    e = [Sym('effects'), [Sym('font'), [Sym('size'), size, size]]]
    if hide:
        e.append([Sym('hide'), Sym('yes')])
    return [Sym('property'), name, val, [Sym('at'), at[0], at[1], 0], e]


def pin(ptype, x, y, ang, num, name, length=5.08):
    f = [Sym('effects'), [Sym('font'), [Sym('size'), 1.27, 1.27]]]
    return [Sym('pin'), Sym(ptype), Sym('line'), [Sym('at'), x, y, ang], [Sym('length'), length],
            [Sym('name'), name, f], [Sym('number'), str(num), f]]


def cm5_symbol():
    names = {int(k): v for k, v in json.load(open(os.path.join(HERE, 'cm5_pins.json'))).items()}

    def ptype(n):
        if n in ('GND', '5V', 'GPIO_VREF'):
            return 'power_in'
        if n in ('CM5_3.3V', 'CM5_1.8V'):
            return 'power_out'
        return 'bidirectional'
    s = [Sym('symbol'), 'CM5', [Sym('pin_names'), [Sym('offset'), 1.016]],
         [Sym('exclude_from_sim'), Sym('no')], [Sym('in_bom'), Sym('yes')], [Sym('on_board'), Sym('yes')],
         prop('Reference', 'M', (0, 5.08)), prop('Value', 'CM5', (0, -132.08)),
         prop('Footprint', 'lucht:Raspberry-Pi-5-Compute-Module', hide=True),
         prop('Datasheet', 'https://datasheets.raspberrypi.com/cm5/cm5-datasheet.pdf', hide=True),
         prop('Description', 'Raspberry Pi Compute Module 5 (2x 100-pin DF40)', hide=True)]
    for unit in (1, 2):
        sub = [Sym('symbol'), f'CM5_{unit}_1',
               [Sym('rectangle'), [Sym('start'), -25.4, 2.54], [Sym('end'), 25.4, -127.0],
                [Sym('stroke'), [Sym('width'), 0.254], [Sym('type'), Sym('default')]],
                [Sym('fill'), [Sym('type'), Sym('background')]]],
               [Sym('text'), f'J{unit} pins {(unit-1)*100+1}-{unit*100}', [Sym('at'), 0, 0, 0],
                [Sym('effects'), [Sym('font'), [Sym('size'), 1.27, 1.27]]]]]
        seen = set()
        for i in range(50):
            for side, n in ((0, (unit - 1) * 100 + 2 * i + 1), (1, (unit - 1) * 100 + 2 * i + 2)):
                nm = names[n]; t = ptype(nm)
                if nm in seen and t.startswith('power'):
                    t = 'passive'
                seen.add(nm)
                y = -2.54 * i - 2.54
                sub.append(pin(t, -30.48 if side == 0 else 30.48, y, 0 if side == 0 else 180, n, nm))
        s.append(sub)
    s.append([Sym('embedded_fonts'), Sym('no')])
    return s


def box_symbol(name, ref, left, right, descr, fp):
    """simple rectangle symbol: left / right = [(number, name, type)]"""
    h = 2.54 * max(len(left), len(right))
    s = [Sym('symbol'), name, [Sym('pin_names'), [Sym('offset'), 1.016]],
         [Sym('exclude_from_sim'), Sym('no')], [Sym('in_bom'), Sym('yes')], [Sym('on_board'), Sym('yes')],
         prop('Reference', ref, (0, h / 2 + 2.54)), prop('Value', name, (0, -h / 2 - 2.54)),
         prop('Footprint', fp, hide=True), prop('Datasheet', '', hide=True), prop('Description', descr, hide=True)]
    sub = [Sym('symbol'), name + '_1_1',
           [Sym('rectangle'), [Sym('start'), -7.62, h / 2 + 1.27], [Sym('end'), 7.62, -h / 2 - 1.27],
            [Sym('stroke'), [Sym('width'), 0.254], [Sym('type'), Sym('default')]], [Sym('fill'), [Sym('type'), Sym('background')]]]]
    for side, lst in ((0, left), (1, right)):
        for i, (num, nm, t) in enumerate(lst):
            y = h / 2 - 1.27 - 2.54 * i
            sub.append(pin(t, -12.7 if side == 0 else 12.7, y, 0 if side == 0 else 180, num, nm))
    s.append(sub)
    s.append([Sym('embedded_fonts'), Sym('no')])
    return s


def build_sym_lib():
    out = {}
    for p in design.parts:
        sid = p['sym']; n = sym_name(sid)
        if n in out:
            continue
        if sid == 'lucht:TPS61023':
            out[n] = box_symbol('TPS61023', 'U', [(1, 'FB', 'input'), (2, 'EN', 'input'), (3, 'VIN', 'power_in')],
                                [(6, 'VOUT', 'power_out'), (5, 'SW', 'passive'), (4, 'GND', 'power_in')],
                                'TI TPS61023 boost converter, SOT-563', 'Package_TO_SOT_SMD:SOT-563')
        elif sid == 'lucht:CM5':
            out[n] = cm5_symbol()
        elif sid == 'lucht:Q_PMOS_GDS':
            s = rename_sym(symlib.get('Device:Q_PMOS'), 'Q_PMOS_GDS')
            m = {'G': '1', 'D': '2', 'S': '3'}
            for sub in find(s, 'symbol'):
                for pn in find(sub, 'pin'):
                    num = find1(pn, 'number'); num[1] = m[num[1]]
            out[n] = s
        else:
            out[n] = symlib.get(sid)
            if n == 'ST25DV04K-IER8C3':
                for sub in find(out[n], 'symbol'):
                    for pn in list(find(sub, 'pin')):
                        if find1(pn, 'number')[1] == '9':
                            sub.remove(pn)
        # point the footprint field to our own lib
        fpid = LIB + ':' + fp_name(p['fp'])
        for e in out[n]:
            if isinstance(e, list) and e[0] == 'property' and e[1] == 'Footprint':
                e[2] = fpid if sid != 'Device:R' and sid != 'Device:C' else ''
    lib = [Sym('kicad_symbol_lib'), [Sym('version'), 20241209], [Sym('generator'), 'lucht_gen'],
           [Sym('generator_version'), '1.0']] + list(out.values())
    open(os.path.join(PRJ, LIB + '.kicad_sym'), 'w').write(dump(lib) + '\n')
    return out


def lib_tables():
    open(os.path.join(PRJ, 'sym-lib-table'), 'w').write(
        '(sym_lib_table\n\t(version 7)\n\t(lib (name "lucht")(type "KiCad")(uri "${KIPRJMOD}/lucht.kicad_sym")(options "")(descr "Luchtmeter S3"))\n)\n')
    open(os.path.join(PRJ, 'fp-lib-table'), 'w').write(
        '(fp_lib_table\n\t(version 7)\n\t(lib (name "lucht")(type "KiCad")(uri "${KIPRJMOD}/lucht.pretty")(options "")(descr "Luchtmeter S3"))\n)\n')


if __name__ == '__main__':
    build_fp_lib(); syms = build_sym_lib(); lib_tables()
    print('footprints + %d symbols written' % len(syms))
    sys.stdout.flush(); os._exit(0)   # KiCad's SWIG objects can crash Python at shutdown
