KVR-CIBER/luchtmeter-s3/(commit log)

2026-10-18 Luchtmeter S3 v1.0: ESP32-S3, SCD41, SHT45, LTR-303, 2.8in touch, BQ24075 LiPo charging, deep-sleep power switch, ESPHome config
2026-10-19 Luchtmeter S3 v2: 4.3in Waveshare touchscreen (FFC), all parts on the back, NFC (ST25DV + PCB coil), WROOM-1U, TPS61023 screen boost, case + renders
2026-10-20 Credit varol56 as co-inventor on silkscreen, schematic and firmware
2026-10-20 4K film of the Luchtmeter (Blender Cycles on lvdell): scene, screen UI frames, overlays, render script
2026-10-21 Name: Kobe Vanrobaeys (README, silkscreen, schematic, firmware, video)
